Nero-198/PLUTO_Phaser/PLUTO_SDR_Beam_former/docs/SOURCES.md

# Document sources

取得日: 2026-07-15

| 保存ファイル | 対象型番 | メーカー | 文書版 | 公式URL | SHA-256 |
| --- | --- | --- | --- | --- | --- |
| `schematic.pdf` | MAPS-010143 | Local KiCad design | 2026-07-15 export | Local file moved from `kicad/schematic.pdf` | `E4A9BB2E23C1E3C88D25C85D0569BD1D13E2B0E7739B67FF0499B012D420161C` |
| `PE4302_datasheet.pdf` | PE4302 / 4302-51 | pSemi (Peregrine Semiconductor) | Document 70-0056-04 | [Official PDF](https://www.psemi.com/wp-content/uploads/pdf/obs/pe4302ds.pdf) | `F9AF2B00FB09D2D30ED51DCE26975580C40BEA9757CBAE5574F8B0092BE89ED5` |
| `SN74HC595_datasheet.pdf` | SN74HC595NSR | Texas Instruments | Rev. J, October 2021 | [Official PDF](https://www.ti.com/lit/gpn/sn74hc595) | `0F692D1315826486598B661FF982237572C44D8942D191CE27C1FDB154D10722` |
| `MAPS_datasheet.pdf` | MAPS-010144-TR0500 | MACOM | Rev. V3 | [Official PDF](https://cdn.macom.com/datasheets/MAPS-010144.pdf) | `41742D57AE76DBACF5363BEBB1F76256C12BF92D97E5A076553C52F5508346A7` |
| `BGB741_datasheet.pdf` | BGB741L7ESD / BGB741L7ESDE6327 | Infineon | v3.1, 2021-07-14 | [Official PDF](https://www.infineon.com/assets/row/public/documents/24/49/infineon-bgb741l7esd-datasheet-en.pdf) | `366C2BB61C48504A50630A22E94780ACF36A79843659462895C9B271FEC96745` |
| `TPS7A2033_datasheet.pdf` | TPS7A2033PDBVR | Texas Instruments | Rev. H, July 2024 | [Official PDF](https://www.ti.com/lit/gpn/tps7a20) | `D0235BF03B67AC27F041ED213CCDC35B969C626341E9713BBEECDD8F98274D8E` |
| `LM2776_datasheet.pdf` | LM2776 | Texas Instruments | Rev. B, February 2017 | [Official PDF](https://www.ti.com/lit/ds/symlink/lm2776.pdf) | `95FD0C6E1F67631A55FEC5C127C98E138285E1894BDB78F8E10A57F9DC1ADF9D` |

## Lifecycle notes

- PE4302 is obsolete; the archived official data sheet identifies PE4312 as its replacement. This repository retains the PE4302 document because the current design uses 4302-51.
- BGB741L7ESD is discontinued. This repository retains its official v3.1 data sheet because it matches the current design.
