Nero-198/PLUTO_Phaser/system_Block.pptx

## PLUTO-BeamFormer ブロック図

2026_01_18

## 概要

- 全体の構成はADALM-Phaserを参考に作る
- https://pysdr.org/content/phaser.html

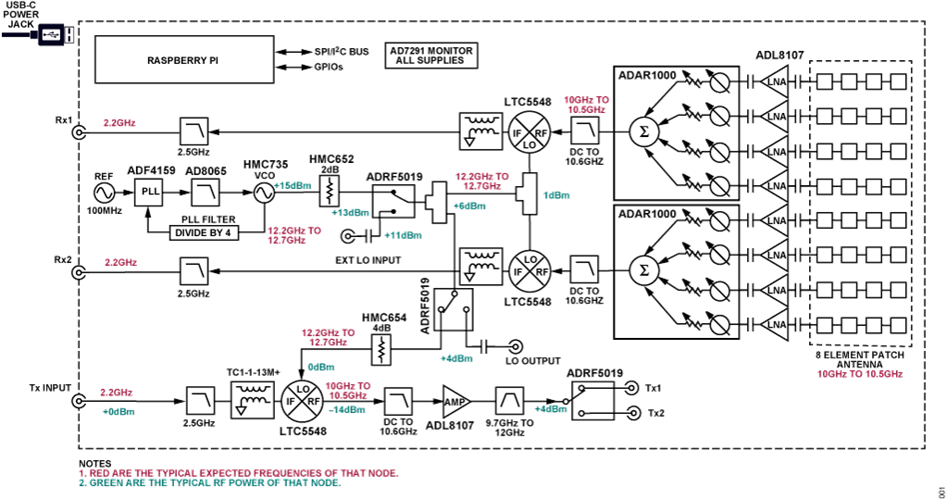
[picture p1: figure]
Detailed block diagram of the Phaser (CN0566)

## 概要

- 自作する場合の図も載っている…?
- https://pysdr.org/content/phaser.html

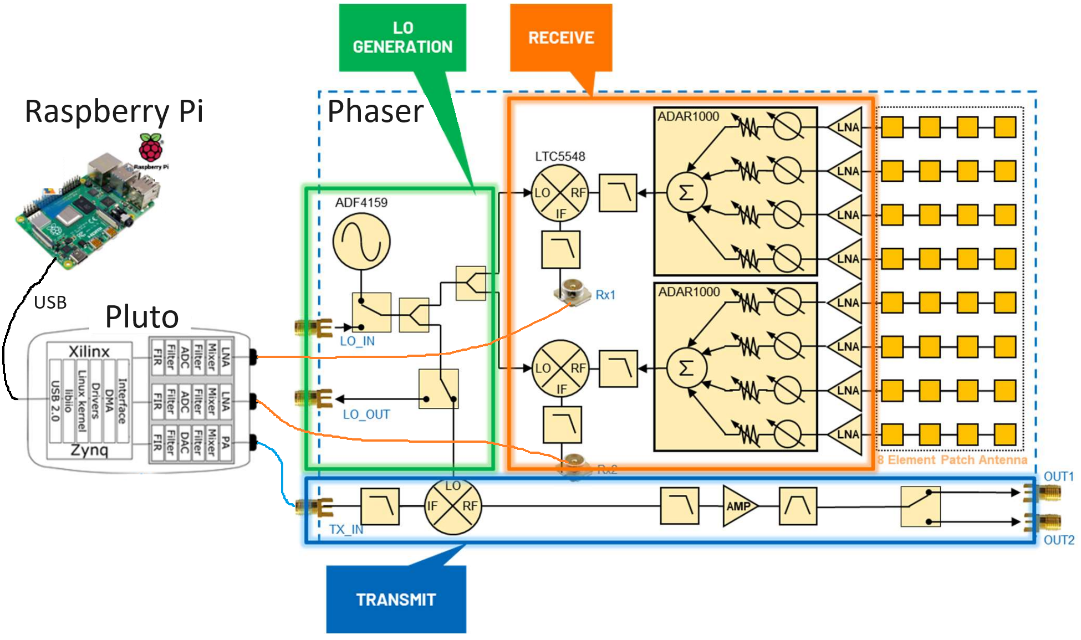
[picture p2: figure]

## Slide 4

VATTも
未定

部品選定が
大変かも

Phase Shifter

LNA

アンテナ

Wilkinson
Divider

Phase Shifter

LNA

Wilkinson
Divider

Wilkinson
Divider

Phase Shifter

LNA

Phase Shifter

LNA

Wilkinson
Divider

Phase Shifter

LNA

Phase Shifter

LNA

Wilkinson
Divider

Phase Shifter

LNA

Phase Shifter

LNA
