Nero-198/PLUTO_Phaser/PLUTO_SDR_Beam_former/reports/phase_frequency_sweep_20260727/frequency_summary.csv

frequency_ghz | channel | rms_phase_error_deg | max_abs_phase_error_deg | mean_phase_error_deg | amplitude_span_db | maximum_repeat_std_deg | minimum_tone_level_dbfs | clipped_sample_count | source_directory
2.3 | 1 | 4.781068088478408 | 8.540999999999997 | -3.606599999999992 | 1.3919999999999995 | 0.079 | -16.328 | 0 | captures/pluto_phase_frequency_sweep_20260727/f2300_ch1
2.3 | 2 | 4.52301249169179 | 8.504999999999995 | -2.4389333333333325 | 1.5139999999999993 | 0.128 | -17.64 | 0 | captures/pluto_phase_frequency_sweep_20260727/f2300_ch2
2.4 | 1 | 2.4634606552571574 | 4.979000000000013 | -1.449333333333336 | 1.0650000000000013 | 0.091 | -17.372 | 0 | captures/pluto_phase_full_20260727_ch1_after_swap
2.4 | 2 | 2.5708967436804357 | 5.049000000000007 | -1.9591333333333312 | 0.8900000000000006 | 0.032 | -17.984 | 0 | captures/pluto_phase_full_20260727_ch2_after_swap
2.5 | 1 | 3.3229594540609946 | 7.112000000000023 | -2.1733999999999982 | 1.3530000000000015 | 0.071 | -19.268 | 0 | captures/pluto_phase_frequency_sweep_20260727/f2500_ch1
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
