Nero-198/PLUTO_Phaser/PLUTO_SDR_Beam_former/reports/phase_frequency_sweep_20260727/phase_error_all_points.csv

frequency_ghz | channel | commanded_phase_deg | measured_phase_magnitude_deg | phase_error_deg | tone_level_dbfs | amplitude_delta_db | circular_std_deg | sample_count | source_directory
2.3 | 1 | 0 | 0.078 | 0.078 | -14.937 | 0 | 0.079 | 4 | captures/pluto_phase_frequency_sweep_20260727/f2300_ch1
2.3 | 1 | 22.5 | 21.351 | -1.149000000000001 | -14.936 | 0.0009999999999994458 | 0.026 | 2 | captures/pluto_phase_frequency_sweep_20260727/f2300_ch1
2.3 | 1 | 45 | 46.285 | 1.2849999999999966 | -15.073 | -0.136000000000001 | 0.003 | 2 | captures/pluto_phase_frequency_sweep_20260727/f2300_ch1
2.3 | 1 | 67.5 | 67.2 | -0.29999999999999716 | -15.393 | -0.4560000000000013 | 0.002 | 2 | captures/pluto_phase_frequency_sweep_20260727/f2300_ch1
2.3 | 1 | 90 | 89.2 | -0.7999999999999972 | -15.99 | -1.0530000000000008 | 0.008 | 2 | captures/pluto_phase_frequency_sweep_20260727/f2300_ch1
2.3 | 1 | 112.5 | 110.494 | -2.0060000000000002 | -15.671 | -0.734 | 0.022 | 2 | captures/pluto_phase_frequency_sweep_20260727/f2300_ch1
2.3 | 1 | 135 | 133.318 | -1.681999999999988 | -15.326 | -0.3890000000000011 | 0.014 | 2 | captures/pluto_phase_frequency_sweep_20260727/f2300_ch1
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
