Nero-198/PLUTO_Phaser/PLUTO_SDR_Beam_former/reports/phase_frequency_sweep_20260727/phase_state_summary.csv

channel | commanded_phase_deg | mean_phase_error_deg | rms_phase_error_deg | max_abs_phase_error_deg | minimum_phase_error_deg | maximum_phase_error_deg | frequency_count
1 | 0 | 0.133125 | 0.2299100367535093 | 0.604 | -0.039 | 0.604 | 8
1 | 22.5 | 0.09125000000000005 | 2.2947396911196702 | 4.302 | -2.529 | 4.302 | 8
1 | 45 | 1.0462499999999988 | 1.2363393547080819 | 2.058 | 0.21099999999999852 | 2.058 | 8
1 | 67.5 | 0.33637499999999854 | 1.85220365375949 | 3.5450000000000017 | -1.558000000000007 | 3.5450000000000017 | 8
1 | 90 | 0.03175000000000061 | 2.1690709992990063 | 4.918999999999997 | -2.2249999999999943 | 4.918999999999997 | 8
1 | 112.5 | -1.4173750000000016 | 2.747865649008337 | 4.528000000000006 | -4.528000000000006 | 2.8419999999999987 | 8
1 | 135 | -1.865124999999999 | 2.8676726408361204 | 4.608000000000004 | -4.608000000000004 | 1.76400000000001 | 8
1 | 157.5 | -1.7593749999999986 | 2.7263046188934905 | 4.902999999999992 | -4.902999999999992 | 1.0730000000000075 | 8
1 | 180 | -0.5321249999999971 | 3.2702089191670884 | 5.2479999999999905 | -5.2479999999999905 | 4.171999999999997 | 8
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
