Nero-198/PLUTO_Phaser/PLUTO_SDR_Beam_former/reports/phase_reference_180_20260728/frequency_summary_reference_180.csv

frequency_ghz | channel | rms_error_reference_180_deg | max_abs_error_reference_180_deg | mean_error_reference_180_deg | worst_absolute_commanded_phase_deg | worst_relative_commanded_phase_deg | worst_error_reference_180_deg | rms_error_reference_0_deg | rms_change_180_minus_0_deg | reference_180_original_error_deg
2.3 | 1 | 3.7995167499740403 | 6.532999999999987 | 1.996466666666665 | 45 | -135 | 6.532999999999987 | 4.781068088478408 | -0.9815513385043677 | -5.2479999999999905
2.3 | 2 | 5.313163834602997 | 10.468999999999994 | 3.7787333333333217 | 90 | -90 | 10.468999999999994 | 4.52301249169179 | 0.7901513429112068 | -5.836999999999989
2.4 | 1 | 2.408627479153506 | 4.3910000000000196 | 1.3502000000000085 | 135 | -45 | 4.3910000000000196 | 2.4634606552571574 | -0.05483317610365157 | -2.6270000000000095
2.4 | 2 | 1.8841972119004249 | 3.3100000000000023 | 0.7616666666666608 | 135 | -45 | 3.3100000000000023 | 2.5708967436804357 | -0.6866995317800109 | -2.5519999999999925
2.5 | 1 | 2.5849178194544895 | 5.3110000000000355 | -0.2500000000000114 | 337.5 | 157.5 | -5.3110000000000355 | 3.3229594540609946 | -0.7380416346065051 | -1.8009999999999877
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
