Nero-198/PLUTO_Phaser/PLUTO_SDR_Beam_former/reports/phase_reference_180_20260728/phase_error_reference_180_all_points.csv

frequency_ghz | channel | absolute_commanded_phase_deg | relative_commanded_from_180_deg | measured_relative_from_180_deg | phase_error_from_180_deg | original_phase_error_from_0_deg | reference_180_measured_magnitude_deg | reference_180_original_error_deg | tone_level_dbfs | amplitude_delta_from_0_db | circular_std_deg | sample_count | source_directory
2.3 | 1 | 0 | -180 | -174.674 | 5.325999999999993 | 0.078 | 174.752 | -5.2479999999999905 | -14.937 | 0 | 0.079 | 4 | captures/pluto_phase_frequency_sweep_20260727/f2300_ch1
2.3 | 1 | 22.5 | -157.5 | -153.401 | 4.0989999999999895 | -1.149000000000001 | 174.752 | -5.2479999999999905 | -14.936 | 0.0009999999999994458 | 0.026 | 2 | captures/pluto_phase_frequency_sweep_20260727/f2300_ch1
2.3 | 1 | 45 | -135 | -128.467 | 6.532999999999987 | 1.2849999999999966 | 174.752 | -5.2479999999999905 | -15.073 | -0.136000000000001 | 0.003 | 2 | captures/pluto_phase_frequency_sweep_20260727/f2300_ch1
2.3 | 1 | 67.5 | -112.5 | -107.552 | 4.947999999999993 | -0.29999999999999716 | 174.752 | -5.2479999999999905 | -15.393 | -0.4560000000000013 | 0.002 | 2 | captures/pluto_phase_frequency_sweep_20260727/f2300_ch1
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
