Nero-198/PLUTO_Phaser/PLUTO_SDR_Beam_former/reports/phase_reference_180_measured_20260728/README.md

# 反対チャネル180°固定 相対位相実測

測定日: 2026-07-28

## 測定方法

各周波数で次の2方向を実測した。

1. 両チャネルを0°に設定し、Rx1/Rx2間の基準相対位相を2回取得
2. CH2を180°に固定し、CH1を0～337.5°まで22.5°刻みで掃引
3. CH1を180°に固定し、CH2を同様に掃引

各掃引状態は2回取得した。期待する相対位相は次のように定義した。

```text
期待相対位相 = wrap(固定チャネル設定 - 掃引チャネル設定)
位相誤差 = wrap(両チャネル0°からの測定相対位相 - 期待相対位相)
```

したがって、掃引チャネルも180°にした状態では期待相対位相が0°になる。

対象周波数は2.3、2.4、2.5、2.7、3.0、3.3、3.5、3.8 GHz。Plutoの設定は前回と同じく、Tx gain -20 dB、Rx gain 30 dB、1 MHz複素トーン、8 MS/s、1キャプチャ16,384 samples、基板ATT 0 dB、LNA両方ONとした。

## 周波数別結果

RMSは固定基準と同じ180°状態を除く15状態から計算した。

| 周波数 (GHz) | 掃引CH | 180°固定CH | RMS誤差 (°) | 最大絶対誤差 (°) | 最大誤差の掃引設定 | 符号付き誤差 (°) | 最大反復標準偏差 (°) |
|---:|---:|---:|---:|---:|---:|---:|---:|
| 2.3 | 1 | 2 | 4.19 | 7.33 | 45° | -7.33 | 0.02 |
| 2.3 | 2 | 1 | 5.03 | 10.03 | 90° | -10.03 | 0.03 |
| 2.4 | 1 | 2 | 2.43 | 4.46 | 135° | -4.46 | 0.02 |
| 2.4 | 2 | 1 | 1.83 | 3.16 | 135° | -3.16 | 0.02 |
| 2.5 | 1 | 2 | 2.58 | 5.30 | 337.5° | +5.30 | 0.03 |
| 2.5 | 2 | 1 | 2.89 | 5.88 | 337.5° | +5.88 | 0.02 |
| 2.7 | 1 | 2 | 3.09 | 5.44 | 157.5° | +5.44 | 0.04 |
| 2.7 | 2 | 1 | 4.78 | 9.00 | 315° | +9.00 | 0.02 |
| 3.0 | 1 | 2 | 4.60 | 7.64 | 157.5° | +7.64 | 0.02 |
| 3.0 | 2 | 1 | 4.85 | 7.79 | 315° | +7.79 | 0.03 |
| 3.3 | 1 | 2 | 2.68 | 4.98 | 112.5° | +4.98 | 0.04 |
| 3.3 | 2 | 1 | 3.44 | 4.60 | 45° | +4.60 | 0.03 |
| 3.5 | 1 | 2 | 3.86 | 6.70 | 90° | -6.70 | 0.05 |
| 3.5 | 2 | 1 | 2.59 | 4.91 | 270° | +4.91 | 0.06 |
| 3.8 | 1 | 2 | 3.18 | 7.06 | 22.5° | -7.06 | 0.05 |
| 3.8 | 2 | 1 | 3.93 | 7.57 | 22.5° | -7.57 | 0.06 |

全周波数をまとめたRMS誤差は、CH1掃引で3.41°、CH2掃引で3.83°だった。

全体の最大絶対誤差は2.3 GHzでCH1を180°固定してCH2を90°に設定したときの10.03°で、期待相対位相+90°に対して測定値は約+79.97°だった。

## 前回の後処理結果との比較

前回は、反対チャネルを0°にした測定結果から各チャネルの180°状態を数学的に差し引いた。今回の直接測定と、その後処理から予測した値との差のRMSは1.49°だった。

特に2.3 GHz CH2の90°設定は、前回の予測が絶対値10.47°、今回の直接測定が10.03°であり、大きな誤差が再現した。

最大残差は3.0 GHz、CH2、337.5°設定の4.11°だった。測定時刻、再設定、温度、両チャネル0°基準の再取得による変動を含むため、校正テーブルを作る場合は反復回数を増やす必要がある。

## 安全性とデータ品質

- 位相掃引キャプチャ: 544
- 両チャネル0°基準キャプチャ: 32
- Rx1クリップ検出: 0
- Rx2クリップ検出: 0
- 最大反復円周標準偏差: 0.06°
- 測定後状態: `EXTERNAL_SAFE`
- LNA1/2: OFF
- ATT1/2: 31.5 dB
- 位相1/2: 0°

## ファイル

- `measured_reference_180_all_points.csv`: 全256点の直接測定結果
- `measured_reference_180_frequency_summary.csv`: 周波数・掃引チャネル別集計
- `direct_vs_postprocessed_comparison.csv`: 前回の後処理予測との比較

元のIQデータと周波数別CSVは `captures/pluto_phase_reference180_20260728` に保存した。

再集計:

```powershell
& .\tools\analyze_measured_phase_reference_180.ps1
```
