Nero-198/PLUTO_Phaser/PLUTO_SDR_Beam_former/reports/phase_reference_180_measured_20260728/direct_vs_postprocessed_comparison.csv

frequency_ghz | swept_channel | swept_commanded_phase_deg | directly_measured_error_deg | predicted_from_previous_sweep_deg | direct_minus_predicted_deg
2.3 | 1 | 0 | -6.041 | -5.325999999999993 | -0.715000000000007
2.3 | 1 | 22.5 | -5.042 | -4.0989999999999895 | -0.9430000000000103
2.3 | 1 | 45 | -7.329 | -6.532999999999987 | -0.7960000000000127
2.3 | 1 | 67.5 | -5.461 | -4.947999999999993 | -0.513000000000007
2.3 | 1 | 90 | -5.094 | -4.447999999999993 | -0.646000000000007
2.3 | 1 | 112.5 | -3.812 | -3.2419999999999902 | -0.5700000000000096
2.3 | 1 | 135 | -4.235 | -3.5660000000000025 | -0.6689999999999978
2.3 | 1 | 157.5 | -6.899 | -6.320999999999998 | -0.5780000000000021
2.3 | 1 | 180 | -0.513 | 0 | -0.513
2.3 | 1 | 202.5 | 1.058 | 1.3269999999999982 | -0.26899999999999813
2.3 | 1 | 225 | -1.201 | -0.7849999999999966 | -0.4160000000000035
2.3 | 1 | 247.5 | 0.121 | 0.9230000000000018 | -0.8020000000000018
2.3 | 1 | 270 | -0.431 | 0.117999999999995 | -0.548999999999995
2.3 | 1 | 292.5 | 1.705 | 2.3109999999999786 | -0.6059999999999786
2.3 | 1 | 315 | 2.506 | 3.2930000000000064 | -0.7870000000000066
2.3 | 1 | 337.5 | 0.512 | 1.3489999999999895 | -0.8369999999999895
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
