Nero-198/PLUTO_Phaser/PLUTO_SDR_Beam_former/reports/phase_reference_180_measured_20260728/measured_reference_180_all_points.csv

frequency_ghz | swept_channel | reference_channel | reference_phase_deg | swept_commanded_phase_deg | expected_relative_phase_deg | measured_relative_phase_deg | signed_phase_error_deg | repeat_circular_std_deg | sample_count | ch1_tone_mean_dbfs | ch2_tone_mean_dbfs | source_directory
2.3 | 1 | 2 | 180 | 0 | -180 | 173.959 | -6.041 | 0.024 | 4 | -14.72 | -16.23 | C:/Users/iroen/OneDrive/Documents/Projects/PLUTO_Phaser/PLUTO_SDR_Beam_former/captures/pluto_phase_reference180_20260728/f2300_sweep_ch1_reference_ch2_180deg
2.3 | 1 | 2 | 180 | 22.5 | 157.5 | 152.458 | -5.042 | 0.004 | 2 | -14.777 | -16.23 | C:/Users/iroen/OneDrive/Documents/Projects/PLUTO_Phaser/PLUTO_SDR_Beam_former/captures/pluto_phase_reference180_20260728/f2300_sweep_ch1_reference_ch2_180deg
2.3 | 1 | 2 | 180 | 45 | 135 | 127.671 | -7.329 | 0.003 | 2 | -14.854 | -16.214 | C:/Users/iroen/OneDrive/Documents/Projects/PLUTO_Phaser/PLUTO_SDR_Beam_former/captures/pluto_phase_reference180_20260728/f2300_sweep_ch1_reference_ch2_180deg
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
