Nero-198/PLUTO_Phaser/PLUTO_SDR_Beam_former/docs/schematic.pdf

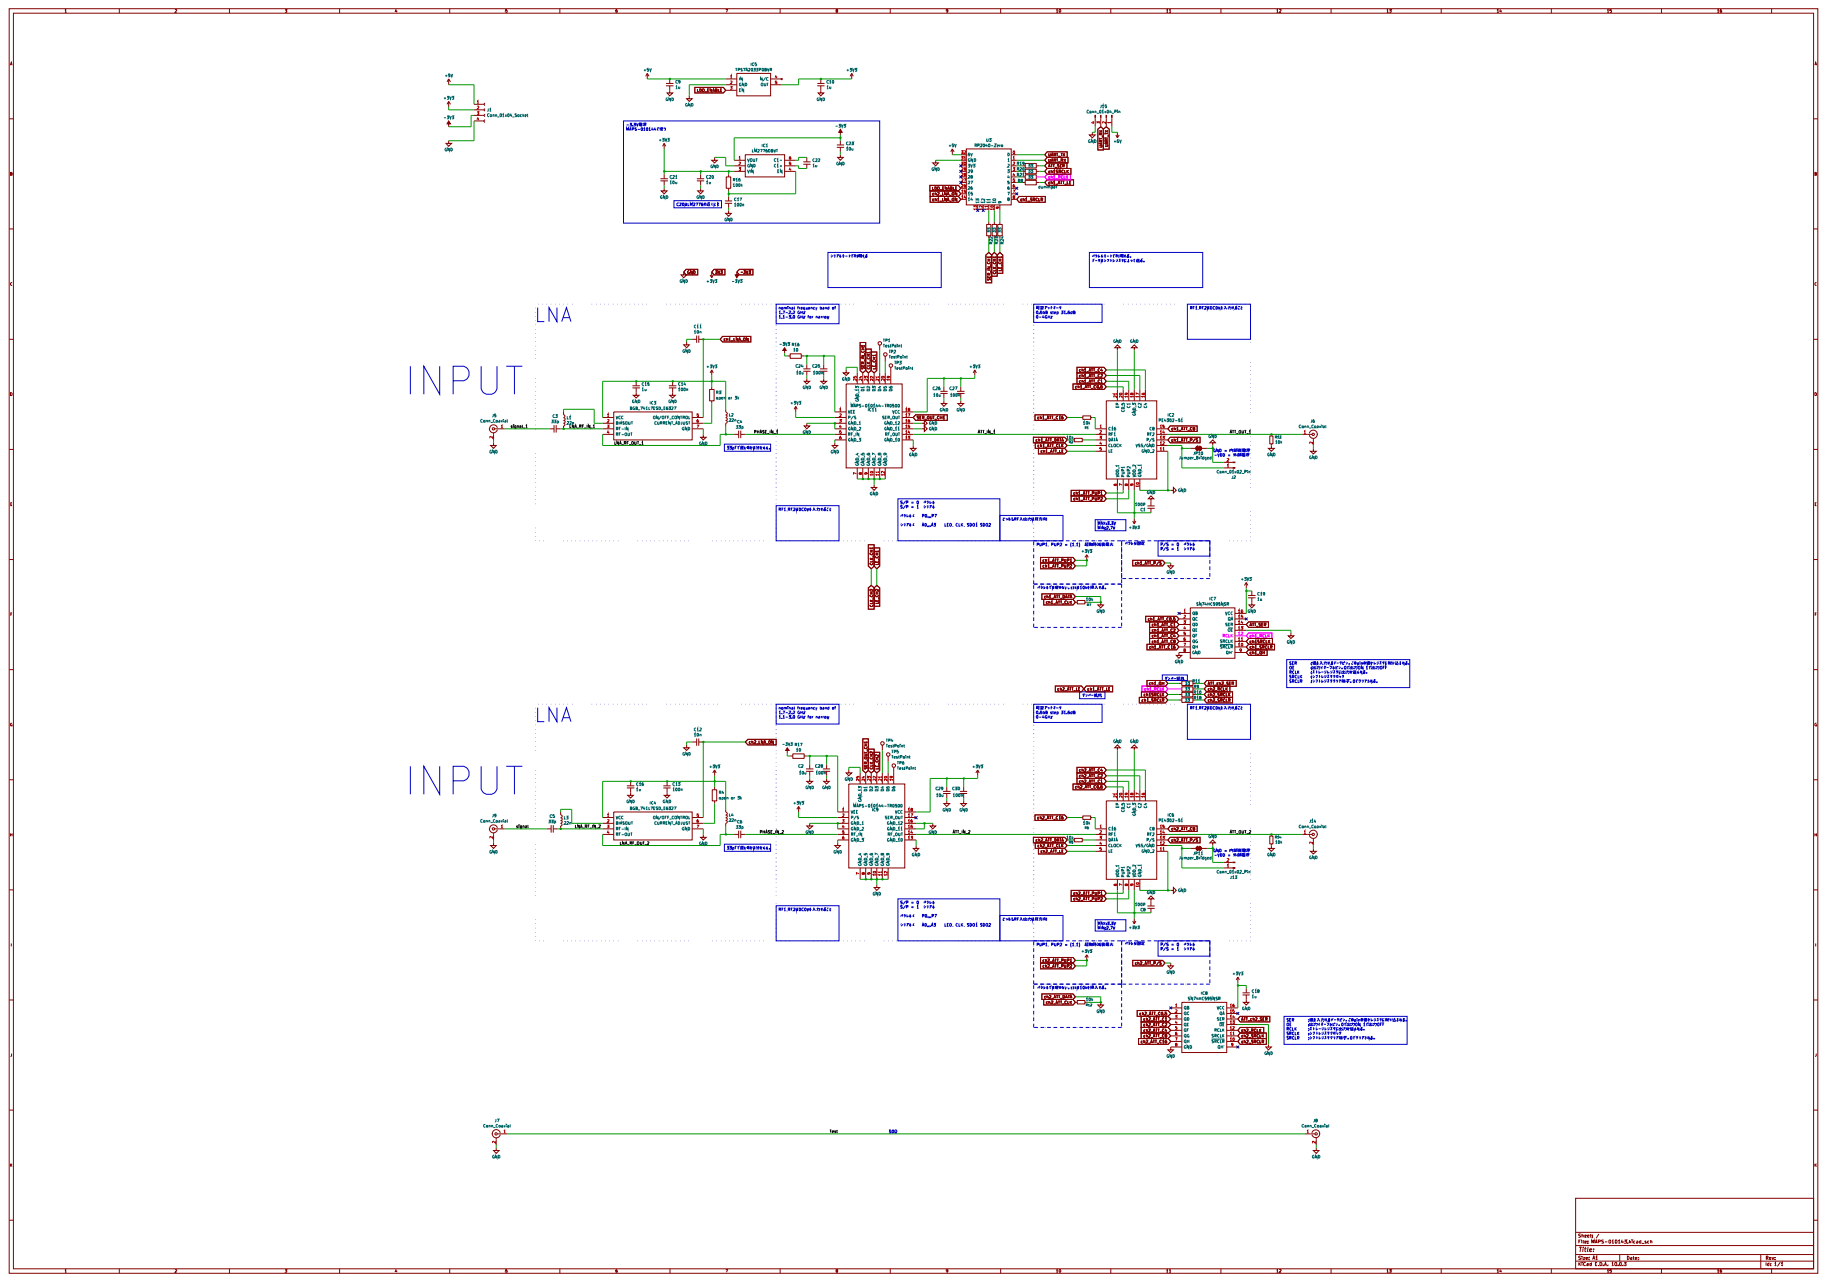
[picture p3: page 1]
