Nero-198/PLUTO_Phaser/PLUTO_SDR_Beam_former/kicad/F.pdf

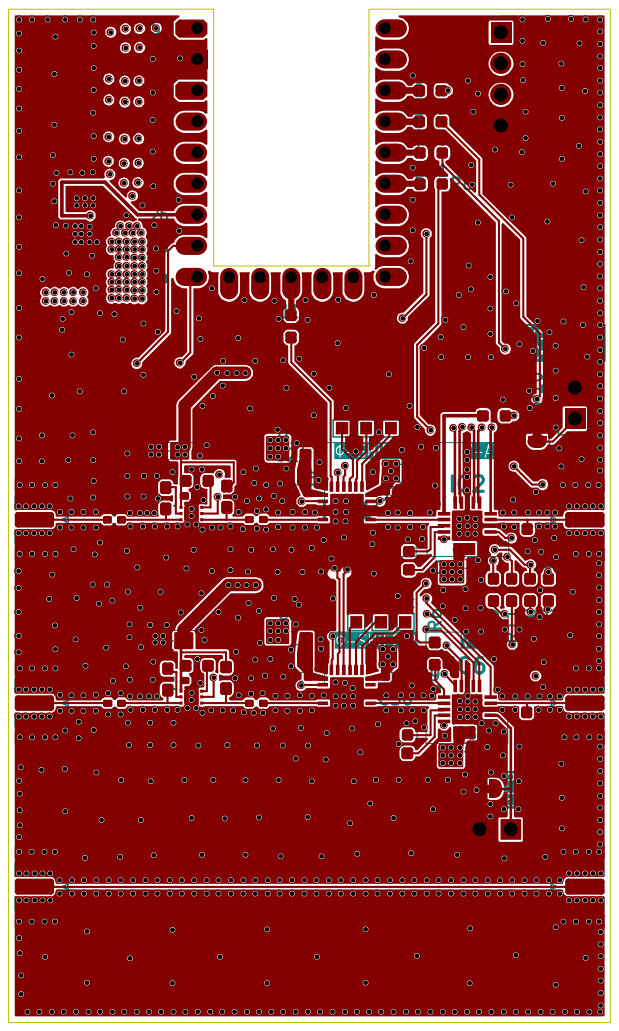
[picture p4: page 1]
