Nero-198/PLUTO_Phaser/(commit log)

2026-05-04 new feature 2ch MAPS
    [DIY_Passiv_IQ_Phase_Shifter_2ch.kicad_pcb, DIY_Passiv_IQ_Phase_Shifter_2ch.kicad_sch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]
2026-05-04 v2 発注記念。
    [MAPS-010143-B_Cu.gbr, MAPS-010143-B_Mask.gbr, MAPS-010143-B_Paste.gbr, MAPS-010143-B_Silkscreen.gbr, MAPS-010143-Edge_Cuts.gbr, MAPS-010143-F_Cu.gbr, MAPS-010143-F_Mask.gbr, MAPS-010143-F_Paste.gbr]
2026-05-13 色々指摘もらったので修正して発注する。
    [MAPS-010143.kicad_pcb, MAPS-010143.kicad_sch]
2026-08-17 えいや！
    [MAPS-010143-B_Cu.gbr, MAPS-010143-B_Mask.gbr, MAPS-010143-B_Paste.gbr, MAPS-010143-B_Silkscreen.gbr, MAPS-010143-Edge_Cuts.gbr, MAPS-010143-F_Cu.gbr, MAPS-010143-F_Mask.gbr, MAPS-010143-F_Paste.gbr]
